Borissimus/2ch-fan-control/out/FAN_CTL.step

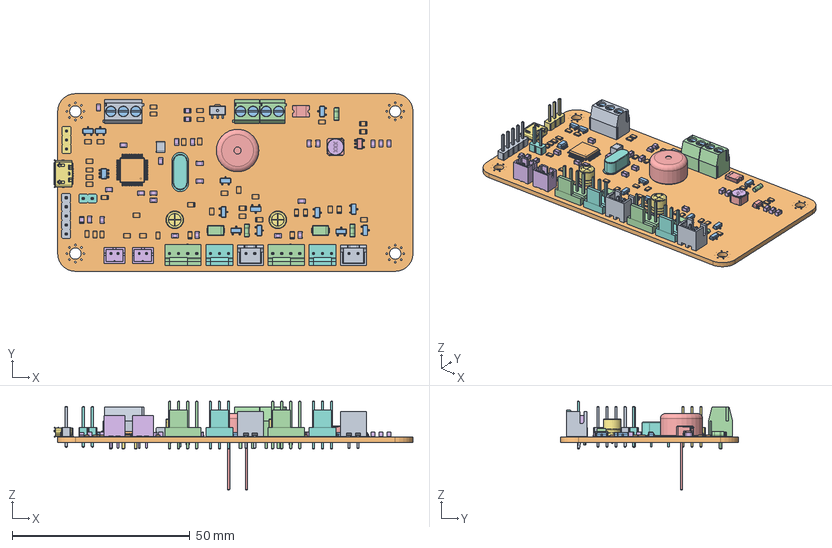
[picture p1: CAD file, 2026-10-09]
out/FAN_CTL.step
101.0 x 50.0 x 25.0 mm
PinHeader_1x05_P2.54mm_Vertical
R_0805_2012Metric x 38
SOT-23 x 12
D_MiniMELF x 3
Fuse1812
C_0805_2012Metric x 23
PinHeader_1x03_P2.54mm_Vertical
FanPinHeader_1x03_P2.54mm_Vertical x 2
FAN_CTL 1.29.1
D_SMA x 2
Buzzer_TDK_PS1240P02BT_D12.2mm_H6.5mm
JST_PH_B2B-PH-K_1x02_P2.00mm_Vertical x 2
CP_Radial_D5.0mm_P2.50mm x 2
PinHeader_1x02_P2.54mm_Vertical
JST_XH_B2B-XH-A_1x02_P2.50mm_Vertical x 2
DG350-3_5-02P-1 x 2
SOT-23-5
LED_0805_2012Metric x 3
DG350-3_5-03P-1
LQFP-48_7x7mm_P0.5mm
SOT-23-6
FanPinHeader_1x04_P2.54mm_Vertical x 2
User Library-CDRH4D28-2
USB_Micro-B_Molex_47346-0001
Crystal_HC49-4H_Vertical
L_1210_3225Metric
FAN_CTL_PCB
