Borissimus/2ch-fan-control/out/FAN_CTL.pdf

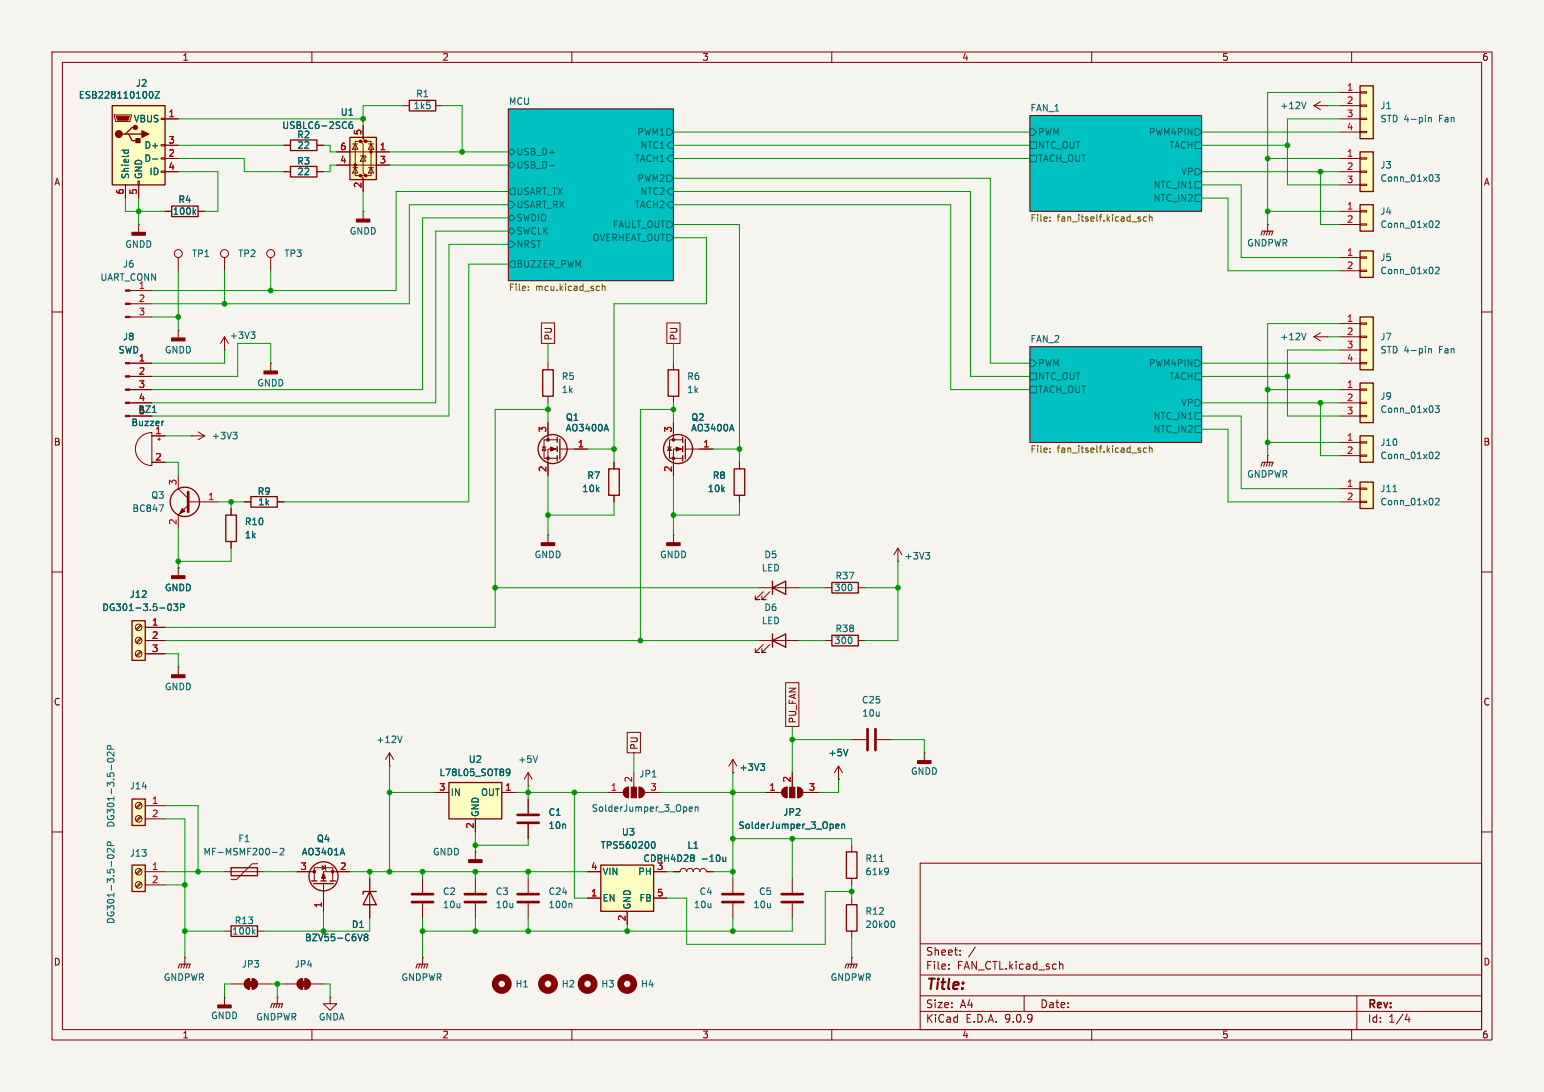
[picture p2: page 1]

Id: 1/4 Title: File: FAN_CTL.kicad_sch Sheet: /

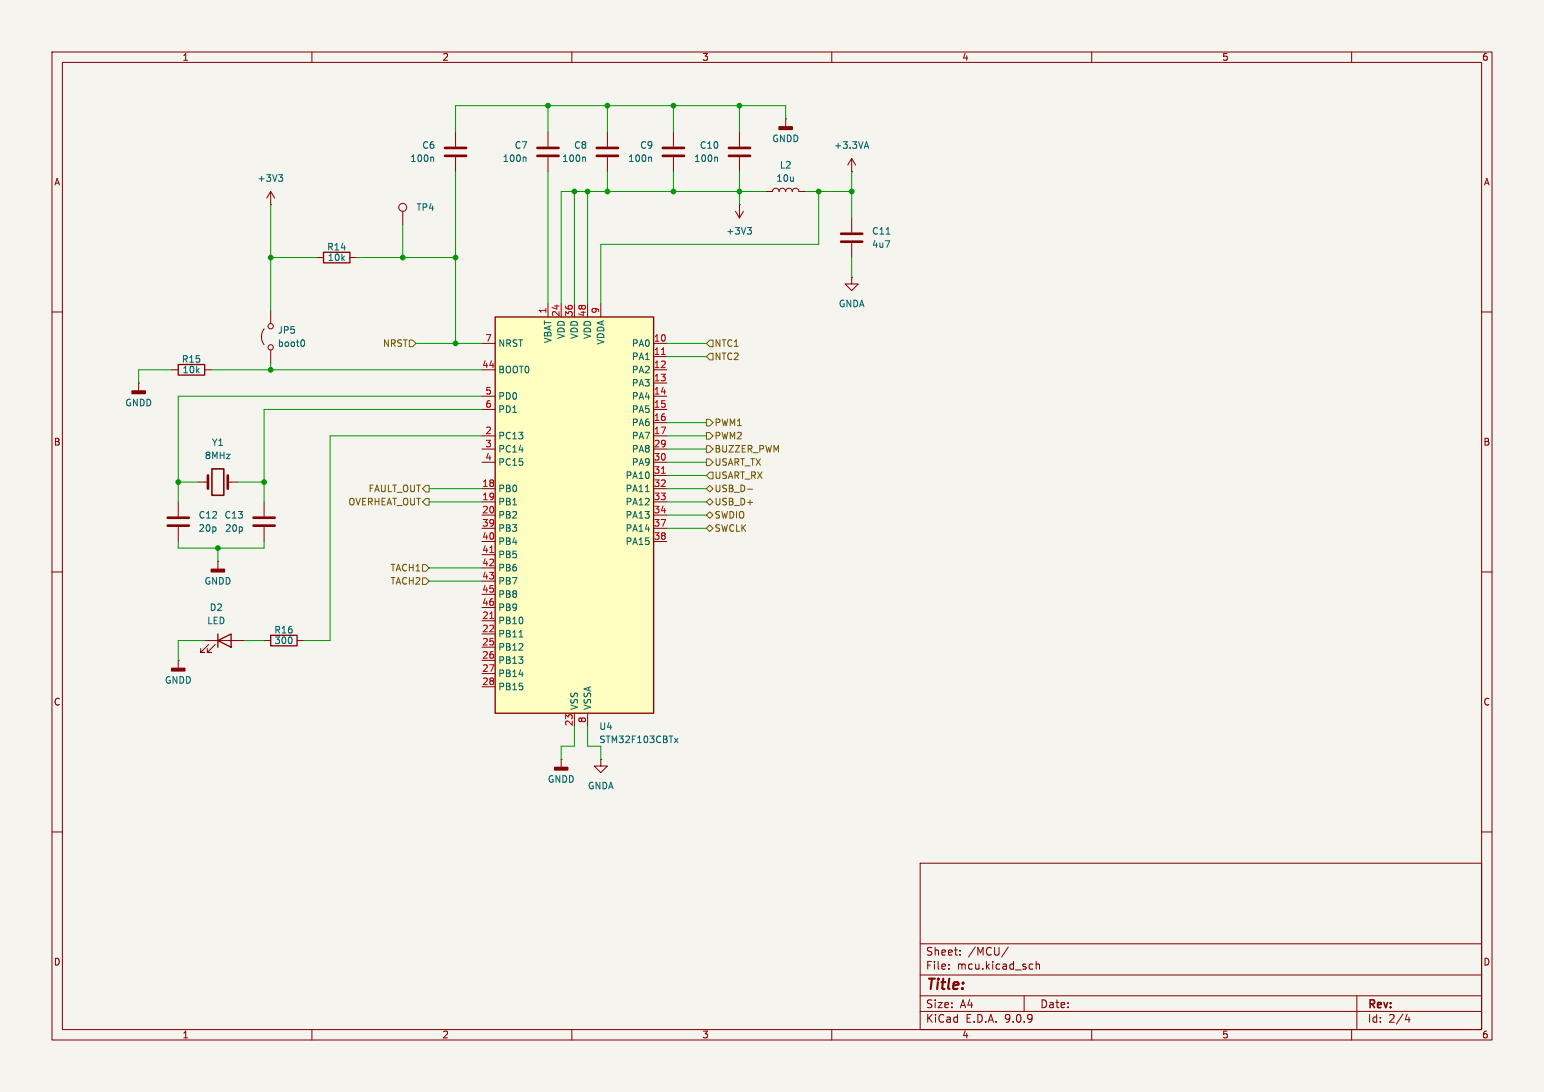
[picture p3: page 2]

Id: 2/4 Title: File: mcu.kicad_sch Sheet: /MCU/

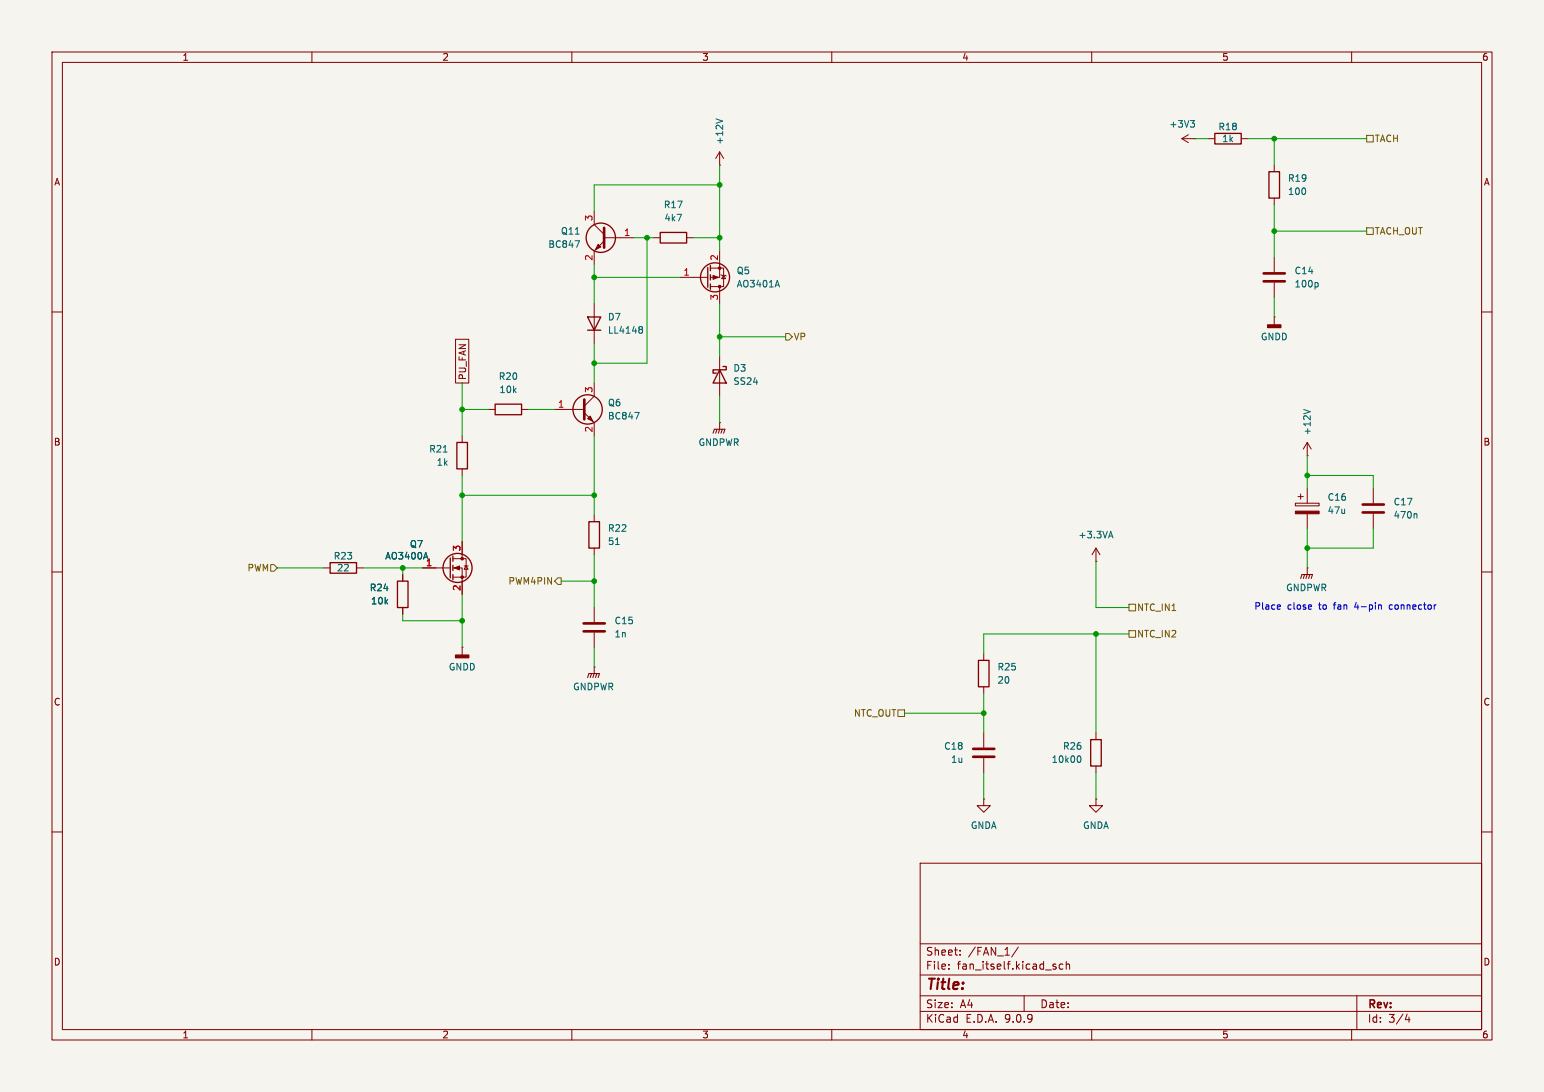
[picture p4: page 3]

Id: 3/4 Title: File: fan_itself.kicad_sch Sheet: /FAN_1/

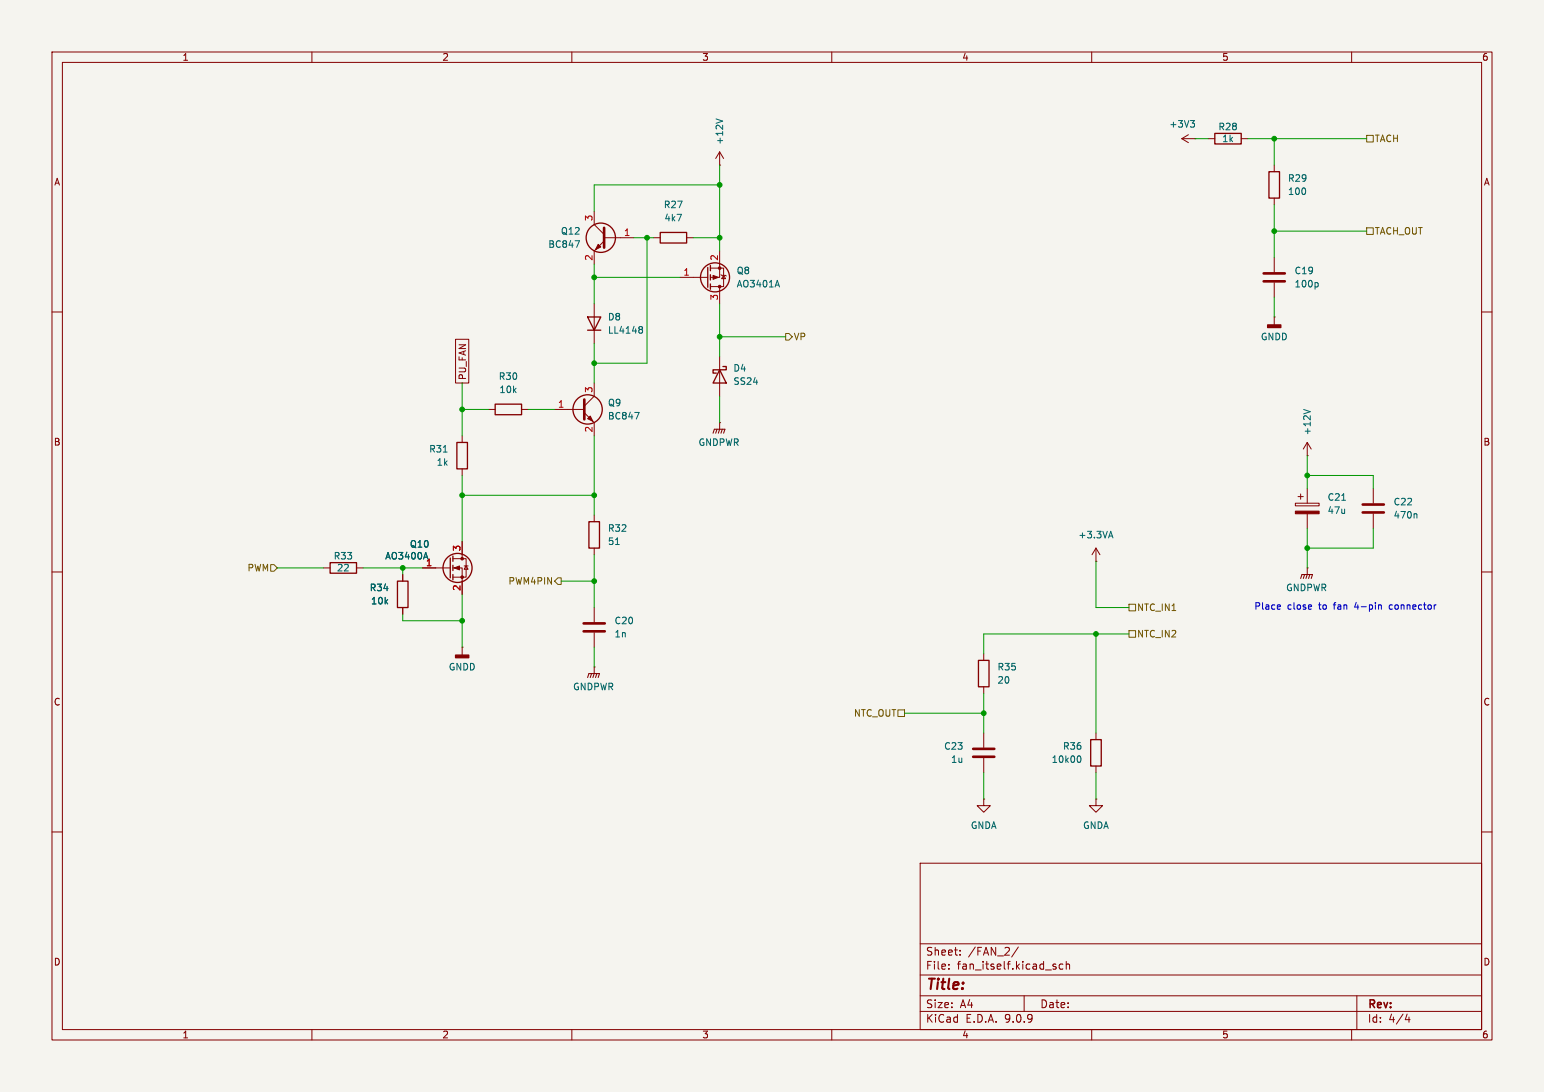
[picture p5: page 4]

Id: 4/4 Title: File: fan_itself.kicad_sch Sheet: /FAN_2/
