Borissimus/2ch-fan-control/FAN_CTL.kicad_pcb

## KiCad design FAN_CTL.kicad_pcb (2026-10-09)

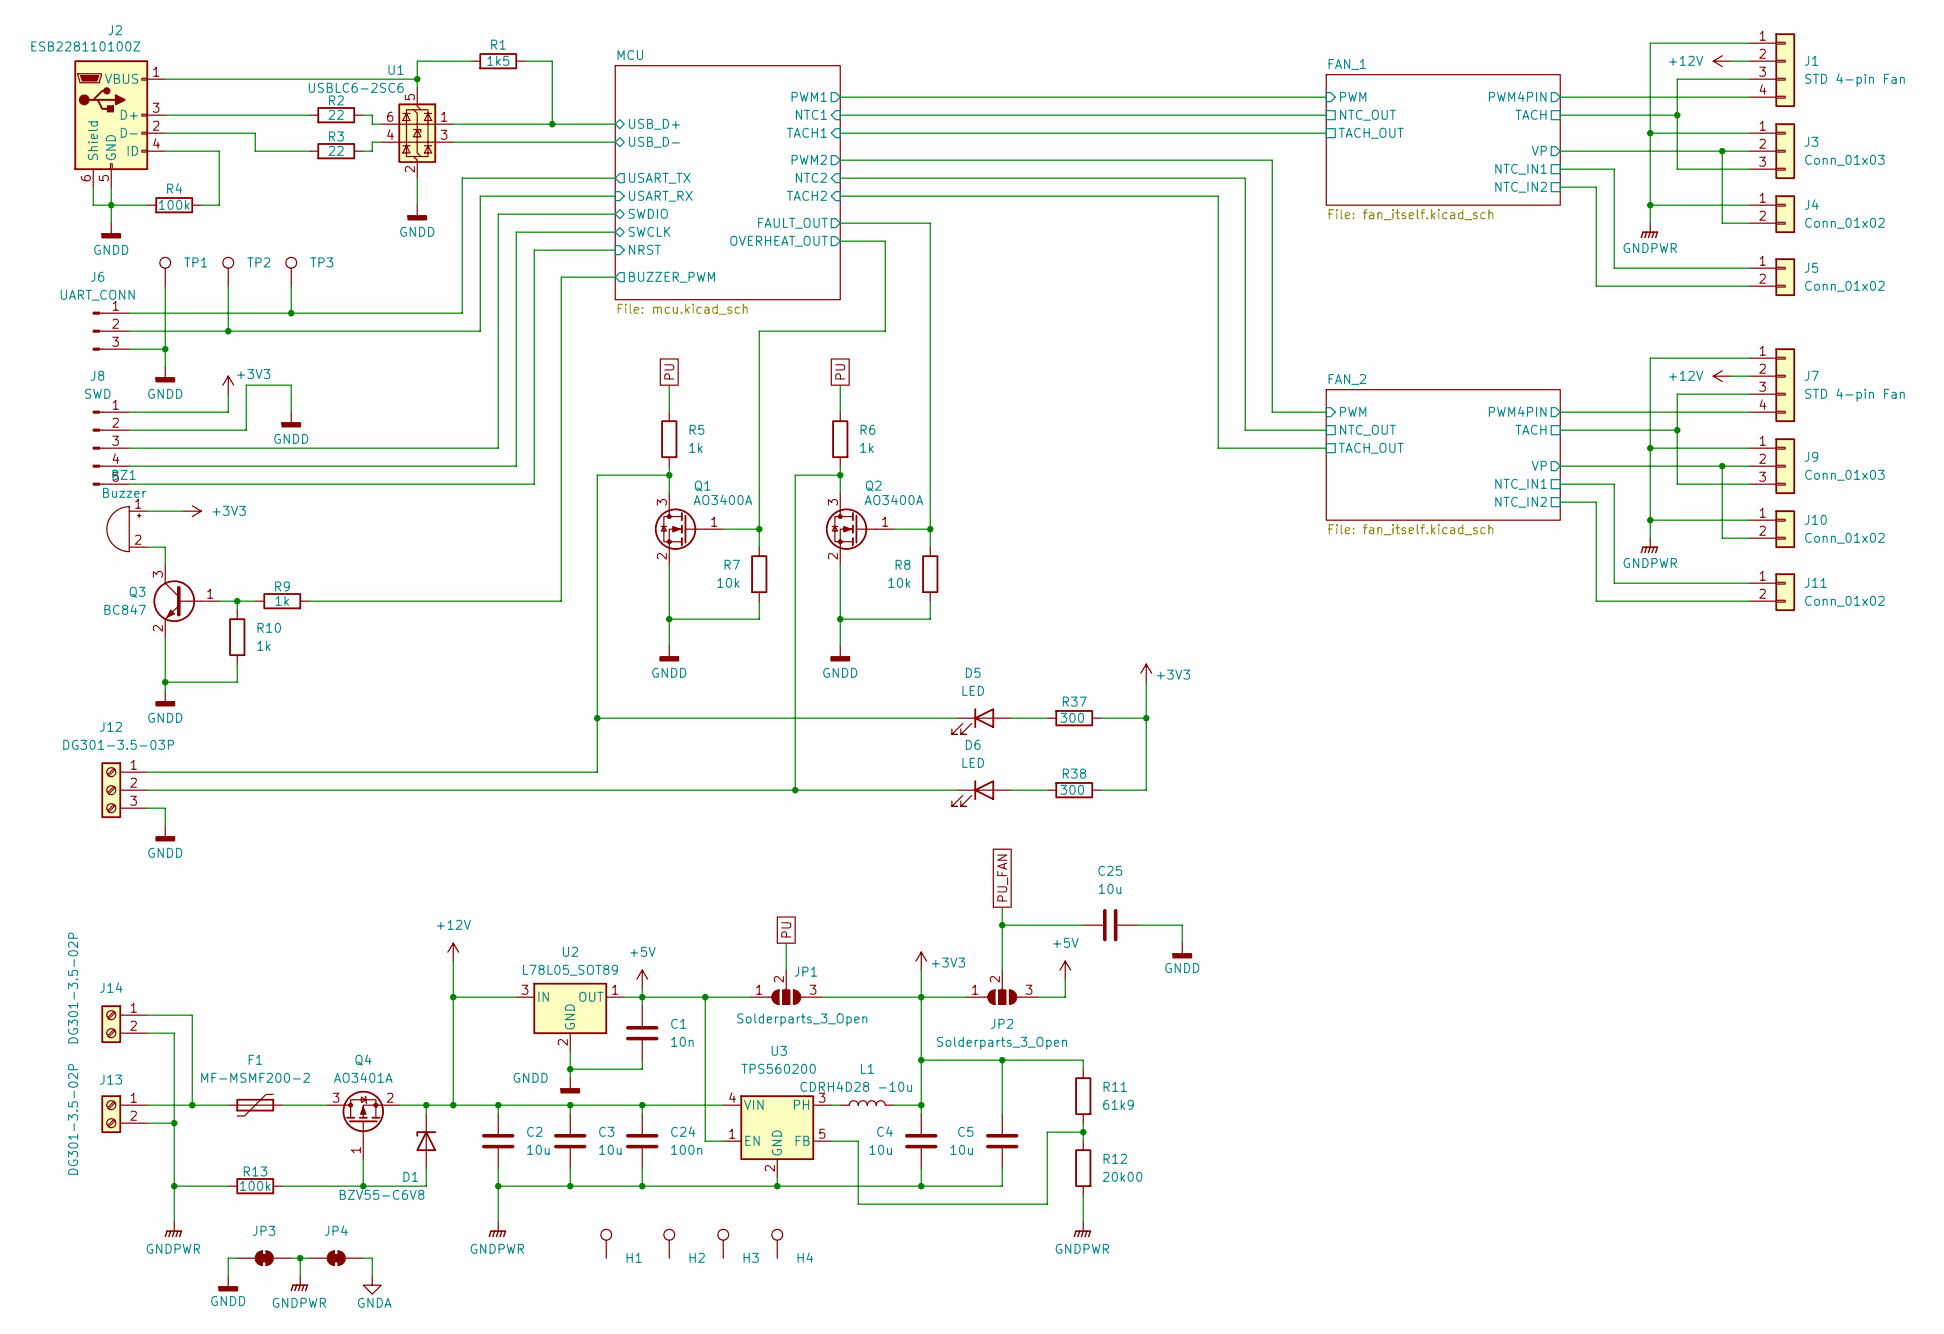
[picture p6: schematic FAN_CTL.kicad_sch]

Parts:
BZ1: Buzzer; Buzzer_TDK_PS1240P02BT_D12.2mm_H6.5mm
C1: 10n; C_0805_2012Metric
C2, C3, C4, C5, C25: 10u; C_0805_2012Metric
C24: 100n; C_0805_2012Metric
D1: BZV55-C6V8; D_MiniMELF
D5, D6: LED; LED_0805_2012Metric
F1: MF-MSMF200-2; Fuse_1812_4532Metric
H1, H2, H3, H4: parts; parts_3.2mm_M3_Pad_Via
J1, J7: STD 4-pin Fan; FanPinHeader_1x04_P2.54mm_Vertical
J2: ESB228110100Z; USB_Micro-B_Molex_47346-0001
J3, J9: Conn_01x03; FanPinHeader_1x03_P2.54mm_Vertical
J4, J10: Conn_01x02; JST_XH_B2B-XH-A_1x02_P2.50mm_Vertical
J5, J11: Conn_01x02; JST_PH_B2B-PH-K_1x02_P2.00mm_Vertical
J6: UART_CONN; PinHeader_1x03_P2.54mm_Vertical
J8: SWD; PinHeader_1x05_P2.54mm_Vertical
J12: DG301-3.5-03P; DG350-3_5-03P
J13, J14: DG301-3.5-02P; DG350-3_5-02P
JP1, JP2: Solderparts_3_Open; Solderparts-3_P1.3mm_Open_RoundedPad1.0x1.5mm
JP3, JP4: Solderparts_2_Bridged; Solderparts-2_P1.3mm_Bridged_Pad1.0x1.5mm
L1: CDRH4D28 -10u; CDRH4D28
Q1, Q2: AO3400A; SOT-23
Q3: BC847; SOT-23
Q4: AO3401A; SOT-23
R1: 1k5; R_0805_2012Metric
R2, R3: 22; R_0805_2012Metric
R4, R13: 100k; R_0805_2012Metric
R5, R6, R9, R10: 1k; R_0805_2012Metric
R7, R8: 10k; R_0805_2012Metric
R11: 61k9; R_0805_2012Metric
R12: 20k00; R_0805_2012Metric
R37, R38: 300; R_0805_2012Metric
TP1, TP2, TP3: parts; parts_Pad_D1.0mm
U1: USBLC6-2SC6; SOT-23-6
U2: L78L05_SOT89; SOT-89-3
U3: TPS560200; SOT-23-5

Connections:
+3.3VA: J5.1, J11.1; also elsewhere on the board
+3V3: BZ1.1 (+), C4.1, C5.1, J8.1, JP1.3 (B), JP2.1 (A), L1.2, R11.1, R37.1, R38.1; also elsewhere on the board
+5V: C1.1, JP1.1 (A), JP2.3 (B), U2.1 (OUT), U3.1 (EN)
+12V: C2.1, C3.1, C24.1, D1.1 (K), J1.2, J7.2, Q4.2 (S), U2.3 (IN), U3.4 (VIN); also elsewhere on the board
/FAN_1/NTC_IN2: J5.2; also elsewhere on the board
/FAN_1/PWM4PIN: J1.4; also elsewhere on the board
/FAN_1/TACH: J1.3, J3.3; also elsewhere on the board
/FAN_1/VP: J3.2, J4.2; also elsewhere on the board
/FAN_2/NTC_IN2: J11.2; also elsewhere on the board
/FAN_2/PWM4PIN: J7.4; also elsewhere on the board
/FAN_2/TACH: J7.3, J9.3; also elsewhere on the board
/FAN_2/VP: J9.2, J10.2; also elsewhere on the board
/MCU/BUZZER_PWM: R9.2; also elsewhere on the board
/MCU/FAULT_OUT: Q2.1 (G), R8.1; also elsewhere on the board
/MCU/NRST: J8.5; also elsewhere on the board
/MCU/OVERHEAT_OUT: Q1.1 (G), R7.1; also elsewhere on the board
/MCU/SWCLK: J8.4; also elsewhere on the board
/MCU/SWDIO: J8.3; also elsewhere on the board
/MCU/USART_RX: J6.2, TP2.1 (1_1); also elsewhere on the board
/MCU/USART_TX: J6.1, TP3.1 (1_1); also elsewhere on the board
/MCU/USB_D+: R1.1, U1.1 (I/O1); also elsewhere on the board
/MCU/USB_D-: U1.3 (I/O2); also elsewhere on the board
GNDA: JP4.2 (B); also elsewhere on the board
GNDD: C1.2, C25.2, J2.5 (GND), J2.6 (Shield), J6.3, J8.2, J12.3, JP3.1 (A), Q1.2 (S), Q2.2 (S), Q3.2 (E), R4.2, R7.2, R8.2, R10.2, TP1.1 (1_1), U1.2 (GND), U2.2 (GND); also elsewhere on the board
GNDPWR: C2.2, C3.2, C4.2, C5.2, C24.2, J1.1, J3.1, J4.1, J7.1, J9.1, J10.1, J13.2, J14.2, JP3.2 (B), JP4.1 (A), R12.2, R13.1, U3.2 (GND); also elsewhere on the board
unnamed: BZ1.2 (-), Q3.3 (C)
unnamed: D1.2 (A), Q4.1 (G), R13.2
unnamed: D5.2 (A), R37.2
unnamed: D5.1 (K), J12.1, Q1.3 (D), R5.2
unnamed: D6.2 (A), R38.2
unnamed: D6.1 (K), J12.2, Q2.3 (D), R6.2
unnamed: J2.3 (D+), R2.2
unnamed: J2.2 (D-), R3.2
unnamed: J2.4 (ID), R4.1
unnamed: J2.1 (VBUS), R1.2, U1.5 (VBUS)
unnamed: F1.1, J13.1, J14.1
unnamed: Q3.1 (B), R9.1, R10.1
unnamed: F1.2, Q4.3 (D)
unnamed: R2.1, U1.6 (I/O1)
unnamed: R3.1, U1.4 (I/O2)
unnamed: R11.2, R12.1, U3.5 (FB)
unnamed: L1.1, U3.3 (PH)
PU: JP1.2 (C), R5.1, R6.1
PU_FAN: C25.1, JP2.2 (C); also elsewhere on the board

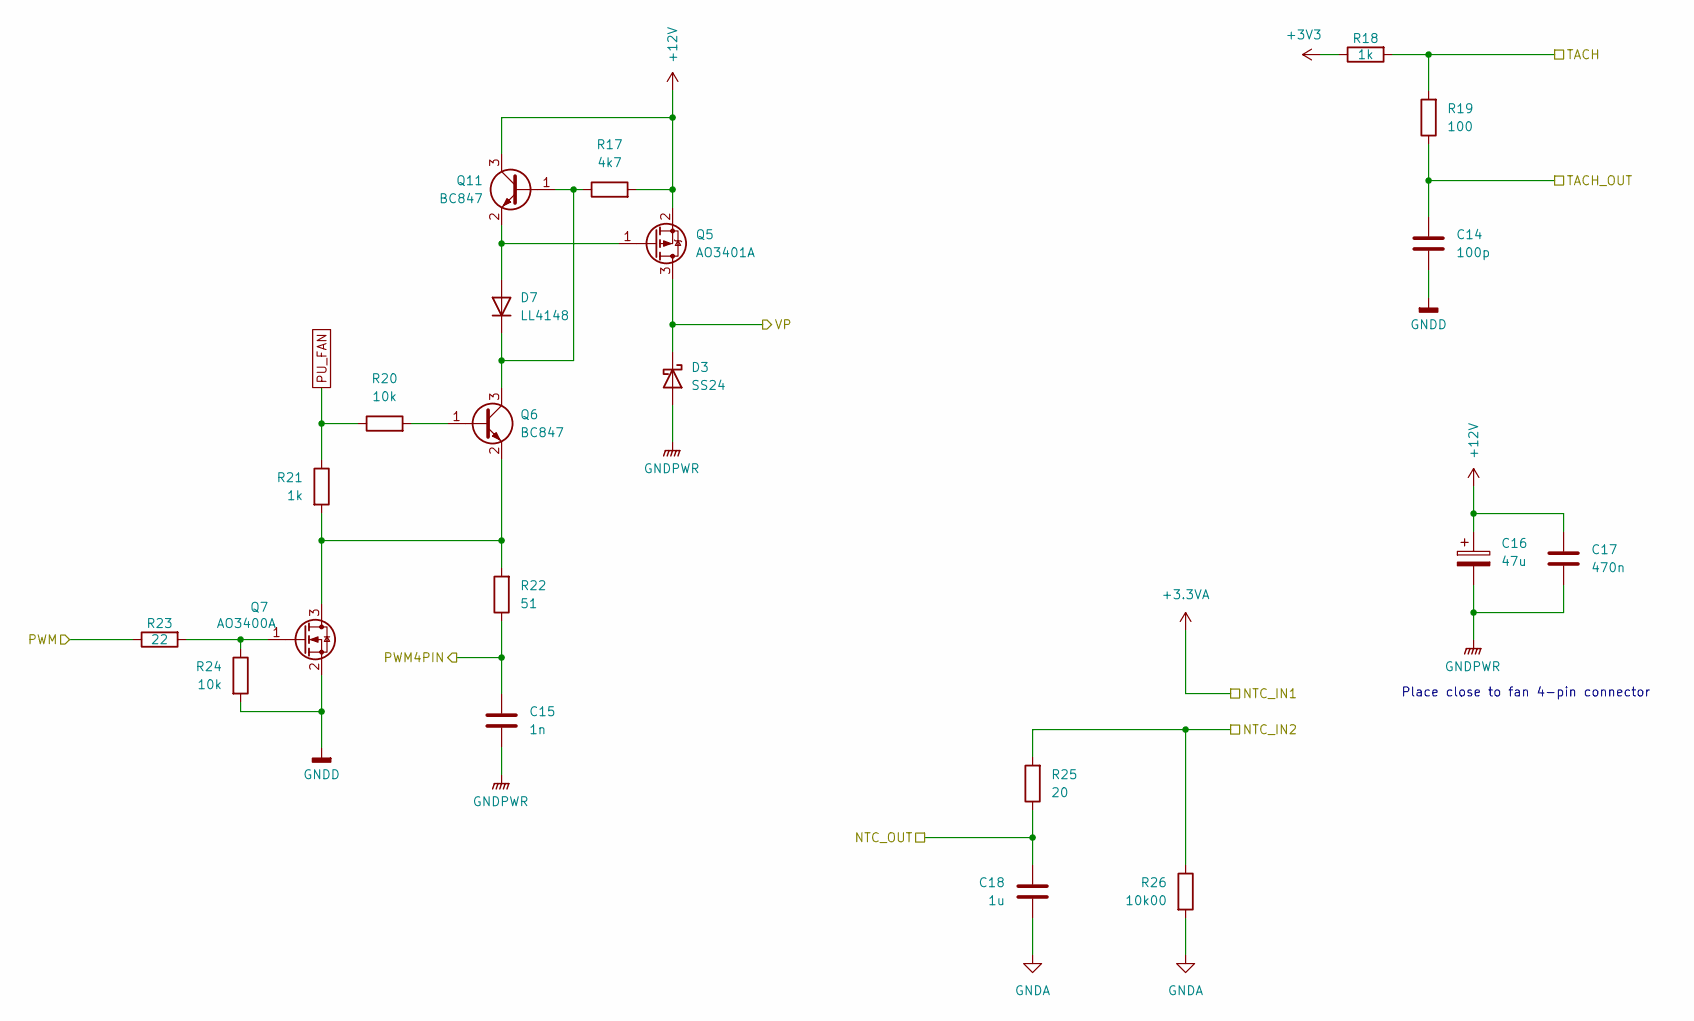
[picture p7: schematic fan_itself.kicad_sch]

Parts:
C14: 100p; C_0805_2012Metric
C15: 1n; C_0805_2012Metric
C16: 47u; CP_Radial_D5.0mm_P2.50mm
C17: 470n; C_0805_2012Metric
C18: 1u; C_0402_1005Metric
D3: SS24; D_SMA
D7: LL4148; D_MiniMELF
Q5: AO3401A; SOT-23
Q6, Q11: BC847; SOT-23
Q7: AO3400A; SOT-23
R17: 4k7; R_0805_2012Metric
R18, R21: 1k; R_0805_2012Metric
R19: 100; R_0805_2012Metric
R20, R24: 10k; R_0805_2012Metric
R22: 51; R_0805_2012Metric
R23: 22; R_0805_2012Metric
R25: 20; R_0402_1005Metric
R26: 10k00; R_0402_1005Metric

Connections:
+3V3: R18.1; also elsewhere on the board
+12V: C16.1, C17.1, Q5.2 (S), Q11.3 (C), R17.2; also elsewhere on the board
/FAN_1/NTC_IN2: R25.2, R26.1; also elsewhere on the board
/FAN_1/NTC_OUT: C18.1, R25.1; also elsewhere on the board
/FAN_1/PWM: R23.1; also elsewhere on the board
/FAN_1/PWM4PIN: C15.1, R22.1; also elsewhere on the board
/FAN_1/TACH: R18.2, R19.2; also elsewhere on the board
/FAN_1/TACH_OUT: C14.1, R19.1; also elsewhere on the board
/FAN_1/VP: D3.1 (K), Q5.3 (D); also elsewhere on the board
GNDA: C18.2, R26.2; also elsewhere on the board
GNDD: C14.2, Q7.2 (S), R24.2; also elsewhere on the board
GNDPWR: C15.2, C16.2, C17.2, D3.2 (A); also elsewhere on the board
unnamed: D7.2 (A), Q5.1 (G), Q11.2 (E)
unnamed: D7.1 (K), Q6.3 (C), Q11.1 (B), R17.1
unnamed: Q6.1 (B), R20.2
unnamed: Q6.2 (E), Q7.3 (D), R21.2, R22.2
unnamed: Q7.1 (G), R23.2, R24.1
PU_FAN: R20.1, R21.1; also elsewhere on the board

Parts of its further copies:
C19: 100p; C_0805_2012Metric
C20: 1n; C_0805_2012Metric
C21: 47u; CP_Radial_D5.0mm_P2.50mm
C22: 470n; C_0805_2012Metric
C23: 1u; C_0402_1005Metric
D4: SS24; D_SMA
D8: LL4148; D_MiniMELF
Q8: AO3401A; SOT-23
Q9, Q12: BC847; SOT-23
Q10: AO3400A; SOT-23
R27: 4k7; R_0805_2012Metric
R28, R31: 1k; R_0805_2012Metric
R29: 100; R_0805_2012Metric
R30, R34: 10k; R_0805_2012Metric
R32: 51; R_0805_2012Metric
R33: 22; R_0805_2012Metric
R35: 20; R_0402_1005Metric
R36: 10k00; R_0402_1005Metric

Connections of its further copies:
+3V3: R28.1; also elsewhere on the board
+12V: C21.1, C22.1, Q8.2 (S), Q12.3 (C), R27.2; also elsewhere on the board
/FAN_2/NTC_IN2: R35.2, R36.1; also elsewhere on the board
/FAN_2/NTC_OUT: C23.1, R35.1; also elsewhere on the board
/FAN_2/PWM: R33.1; also elsewhere on the board
/FAN_2/PWM4PIN: C20.1, R32.1; also elsewhere on the board
/FAN_2/TACH: R28.2, R29.2; also elsewhere on the board
/FAN_2/TACH_OUT: C19.1, R29.1; also elsewhere on the board
/FAN_2/VP: D4.1 (K), Q8.3 (D); also elsewhere on the board
GNDA: C23.2, R36.2; also elsewhere on the board
GNDD: C19.2, Q10.2 (S), R34.2; also elsewhere on the board
GNDPWR: C20.2, C21.2, C22.2, D4.2 (A); also elsewhere on the board
unnamed: D8.2 (A), Q8.1 (G), Q12.2 (E)
unnamed: D8.1 (K), Q9.3 (C), Q12.1 (B), R27.1
unnamed: Q9.1 (B), R30.2
unnamed: Q9.2 (E), Q10.3 (D), R31.2, R32.2
unnamed: Q10.1 (G), R33.2, R34.1
PU_FAN: R30.1, R31.1; also elsewhere on the board

Notes on the sheet:
Place close to fan 4-pin connector

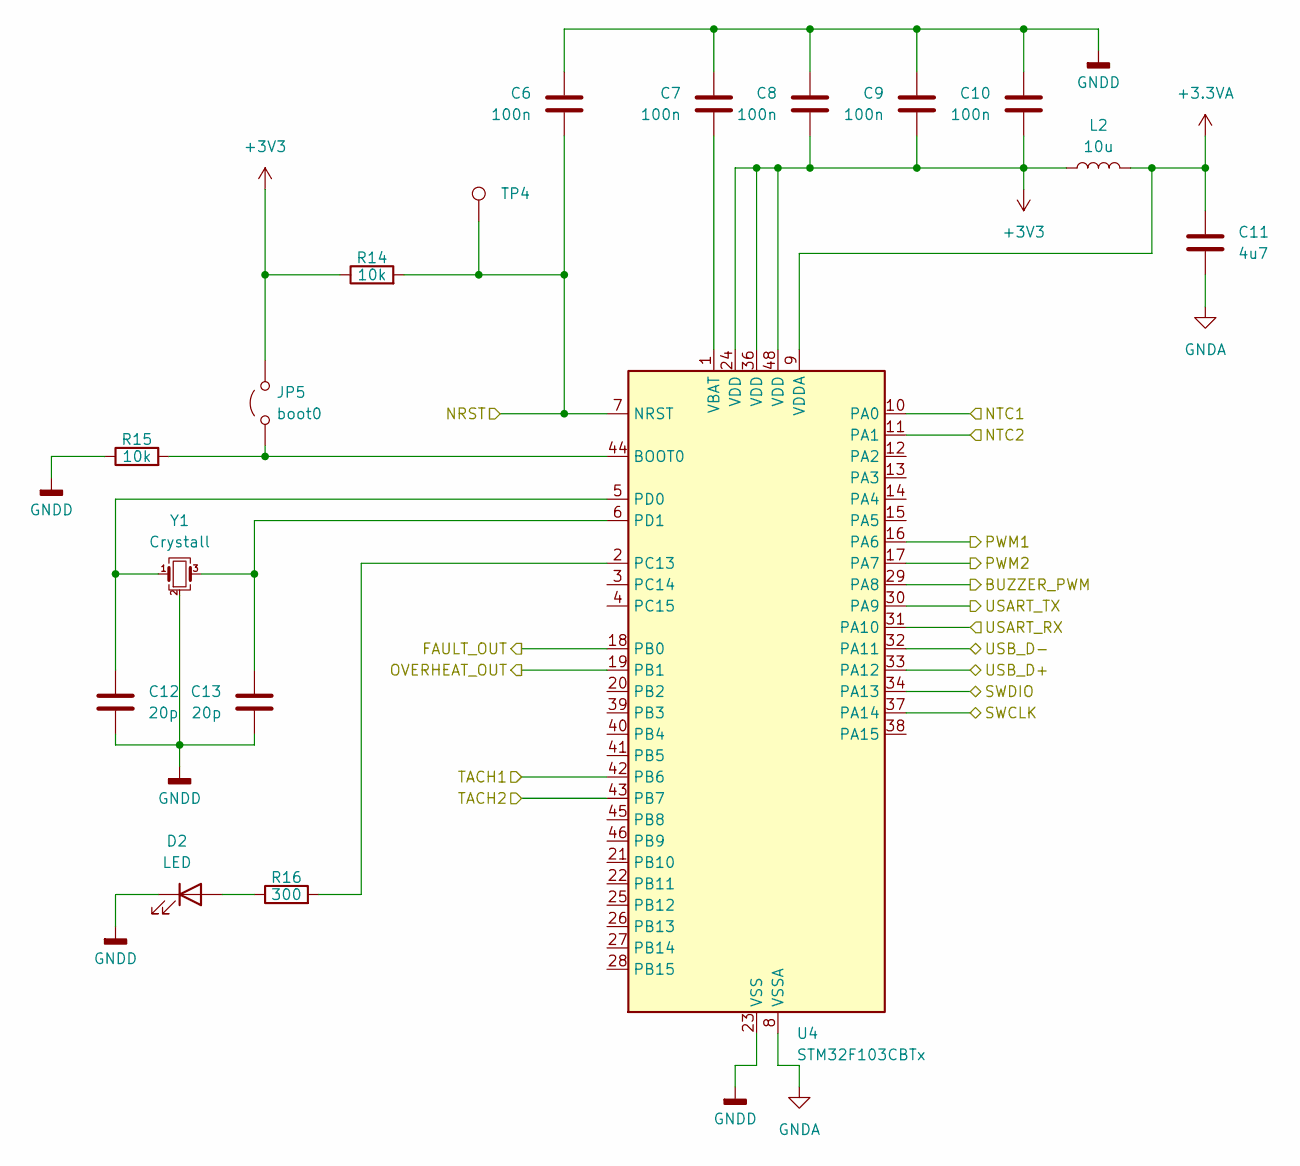
[picture p8: schematic mcu.kicad_sch]

Parts:
C6, C7, C8, C9, C10: 100n; C_0402_1005Metric
C11: 4u7; C_0603_1608Metric
C12, C13: 20p; C_0402_1005Metric
D2: LED; LED_0805_2012Metric
JP5: boot0; PinHeader_1x02_P2.54mm_Vertical
L2: 10u; L_1210_3225Metric
R14, R15: 10k; R_0805_2012Metric
R16: 300; R_0805_2012Metric
TP4: parts; parts_Pad_D1.0mm
U4: STM32F103CBTx; LQFP-48_7x7mm_P0.5mm
Y1: Crystall; Crystal_SMD_5032-4Pin_5.0x3.2mm

Connections:
+3.3VA: C11.1, L2.2, U4.9 (VDDA); also elsewhere on the board
+3V3: C8.2, C9.2, C10.2, JP5.2 (B), L2.1, R14.1, U4.24 (VDD), U4.36 (VDD), U4.48 (VDD); also elsewhere on the board
/FAN_1/NTC_OUT: U4.10 (PA0); also elsewhere on the board
/FAN_1/PWM: U4.16 (PA6); also elsewhere on the board
/FAN_1/TACH_OUT: U4.42 (PB6); also elsewhere on the board
/FAN_2/NTC_OUT: U4.11 (PA1); also elsewhere on the board
/FAN_2/PWM: U4.17 (PA7); also elsewhere on the board
/FAN_2/TACH_OUT: U4.43 (PB7); also elsewhere on the board
/MCU/BUZZER_PWM: U4.29 (PA8); also elsewhere on the board
/MCU/FAULT_OUT: U4.18 (PB0); also elsewhere on the board
/MCU/NRST: C6.2, R14.2, TP4.1 (1_1), U4.7 (NRST); also elsewhere on the board
/MCU/OVERHEAT_OUT: U4.19 (PB1); also elsewhere on the board
/MCU/SWCLK: U4.37 (PA14); also elsewhere on the board
/MCU/SWDIO: U4.34 (PA13); also elsewhere on the board
/MCU/USART_RX: U4.31 (PA10); also elsewhere on the board
/MCU/USART_TX: U4.30 (PA9); also elsewhere on the board
/MCU/USB_D+: U4.33 (PA12); also elsewhere on the board
/MCU/USB_D-: U4.32 (PA11); also elsewhere on the board
GNDA: C11.2, U4.8 (VSSA); also elsewhere on the board
GNDD: C6.1, C7.1, C8.1, C9.1, C10.1, C12.1, C13.1, D2.1 (K), R15.1, U4.23 (VSS), U4.35 (VSS), U4.47 (VSS), Y1.2 (G), Y1.4 (G); also elsewhere on the board
unnamed: D2.2 (A), R16.1
unnamed: JP5.1 (A), R15.2, U4.44 (BOOT0)
unnamed: R16.2, U4.2 (PC13)
unnamed: C12.2, U4.5 (PD0), Y1.1
unnamed: C13.2, U4.6 (PD1), Y1.3
unnamed: C7.2, U4.1 (VBAT)

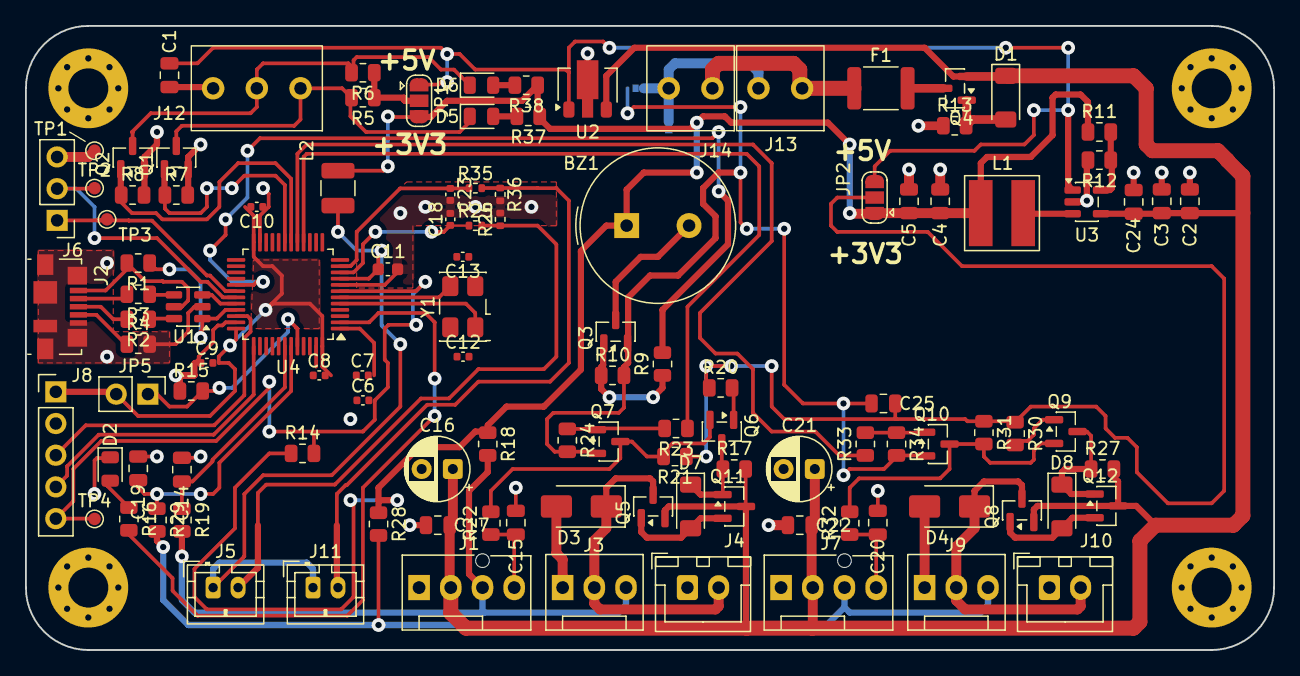
[picture p9: board FAN_CTL.kicad_pcb from above]

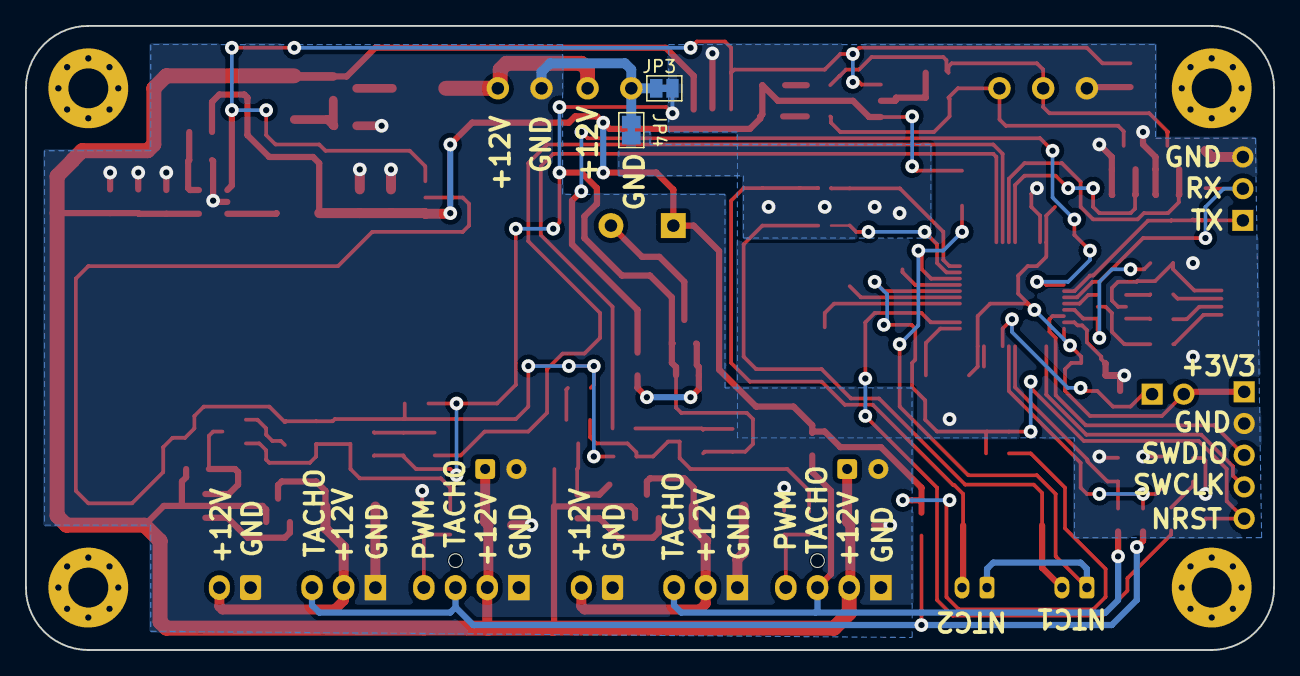
[picture p10: board FAN_CTL.kicad_pcb from below]

Board: 2 copper layers, 100.0 x 50.0 mm, 119 parts (2 on the bottom side), 66 nets.
